claudiusmarius/CONCEPTION-TESTEUR-PILES-PARTIE-1-DFTA247/pinochesss.jpg

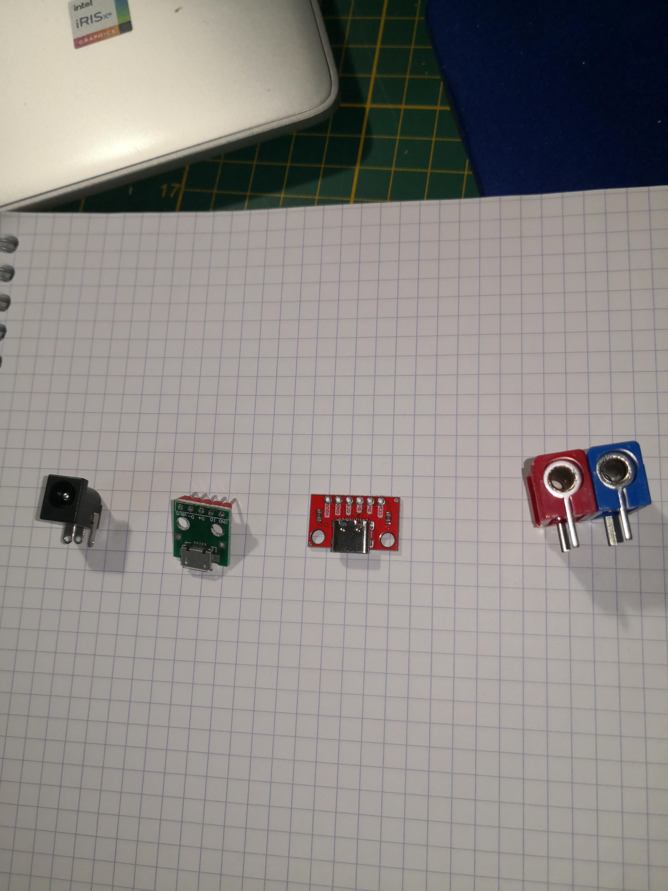
pinochesss.jpg
