claudiusmarius/CONCEPTION-TESTEUR-PILES-PARTIE-1-DFTA247/Schematic_DFTA247_2025-11-29.pdf

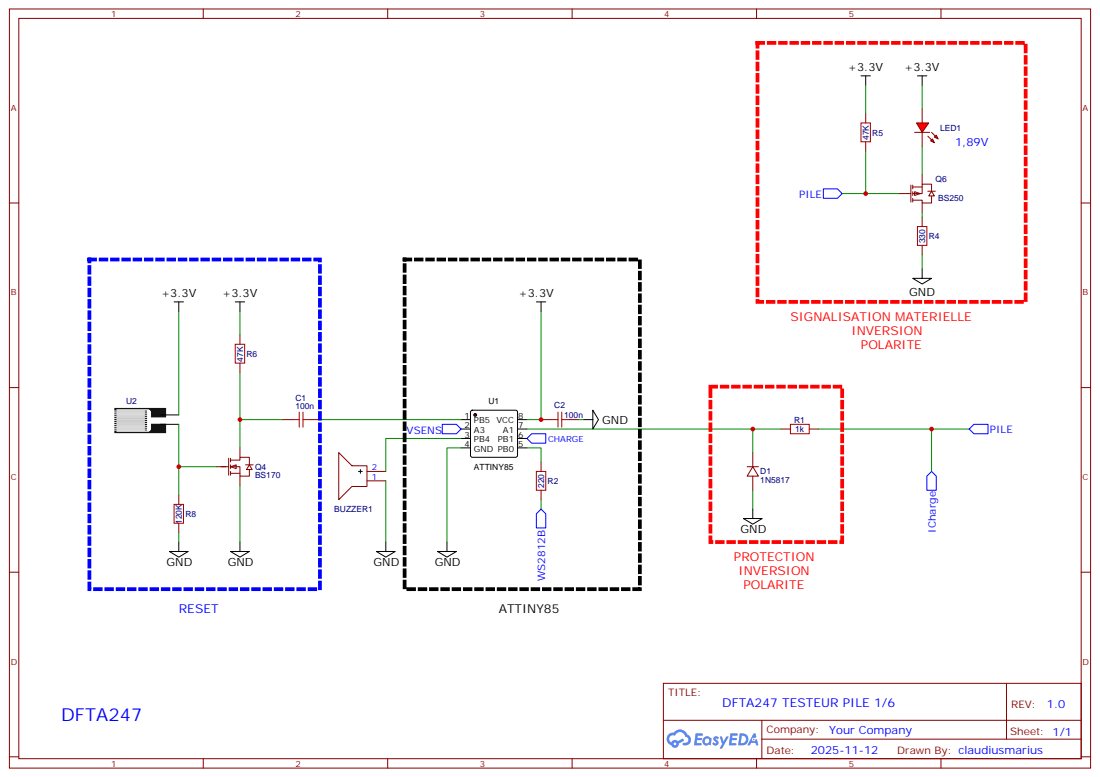
[picture p2: page 1]
