claudiusmarius/CONCEPTION-TESTEUR-PILES-PARTIE-1-DFTA247/Schematic_DFTA247_2025-11-29 (1).pdf

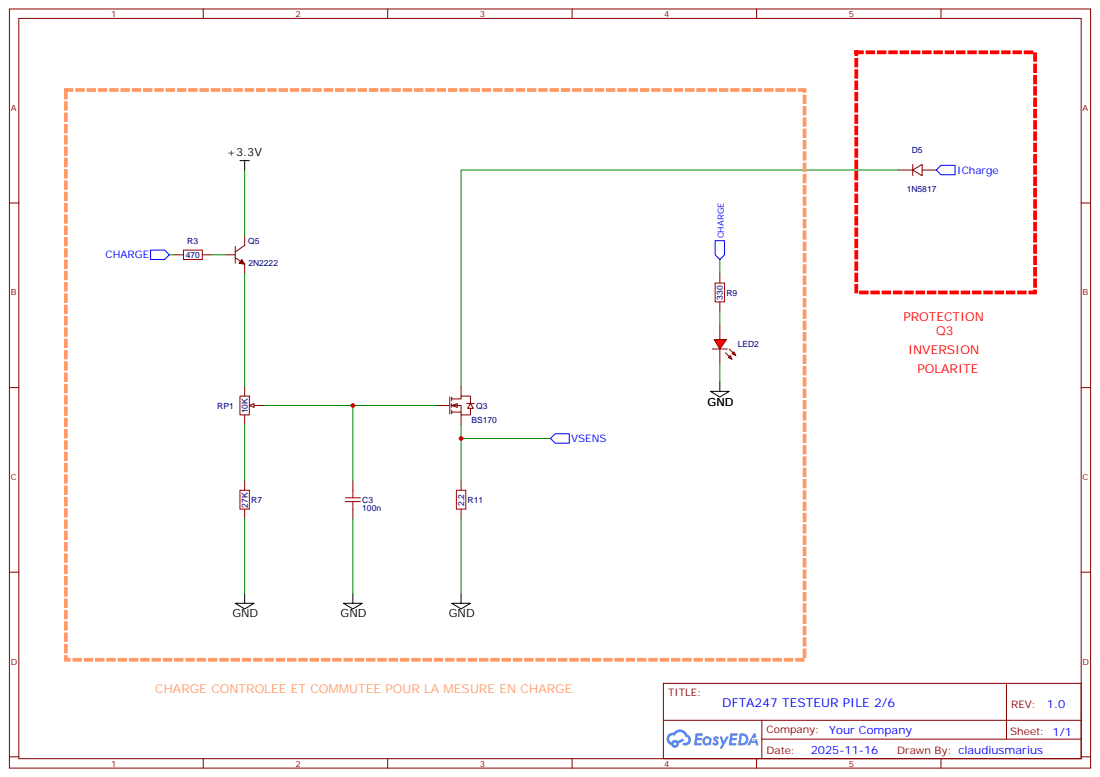
[picture p3: page 1]

CHARGE CONTROLEE ET COMMUTEE POUR LA MESURE EN CHARGE
