claudiusmarius/CONCEPTION-TESTEUR-PILES-PARTIE-1-DFTA247/Schematic_DFTA247_2025-11-29 (2).pdf

+5V

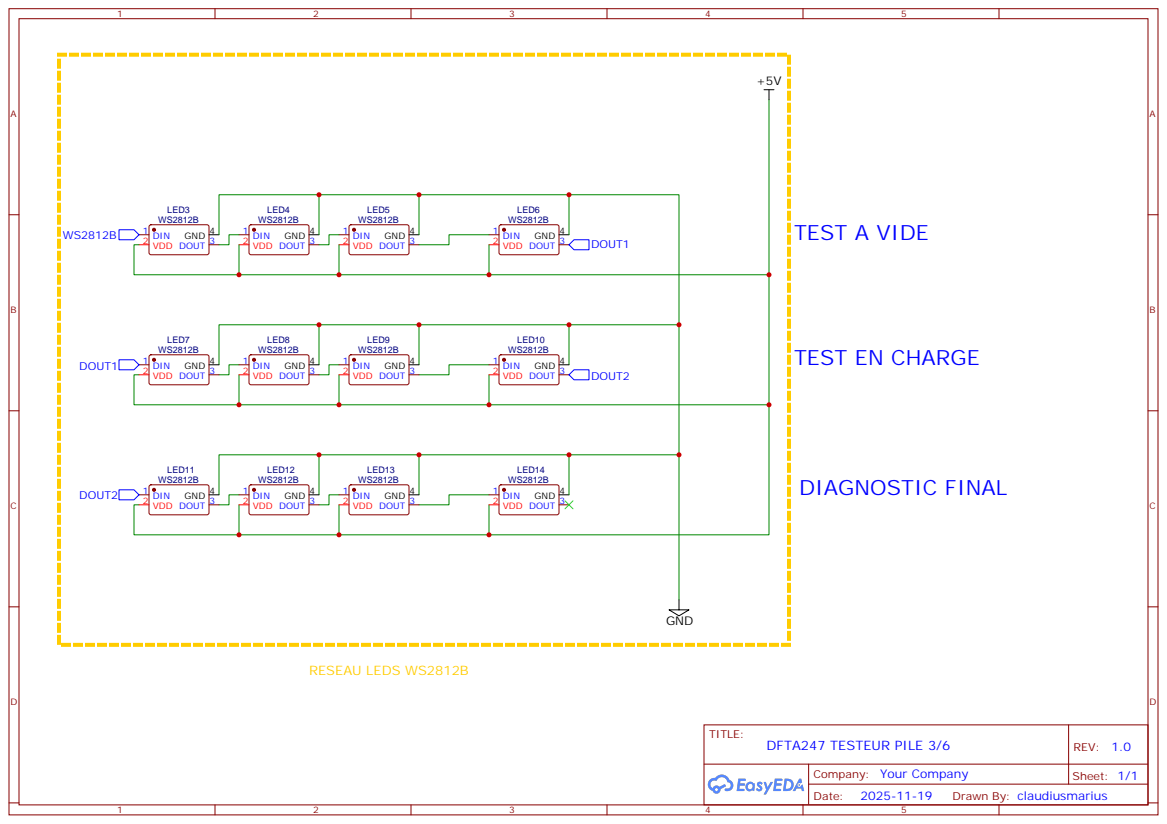
[picture p4: page 1]
