claudiusmarius/CONCEPTION-TESTEUR-PILES-PARTIE-1-DFTA247/Schematic_DFTA247_2025-11-29 (3).pdf

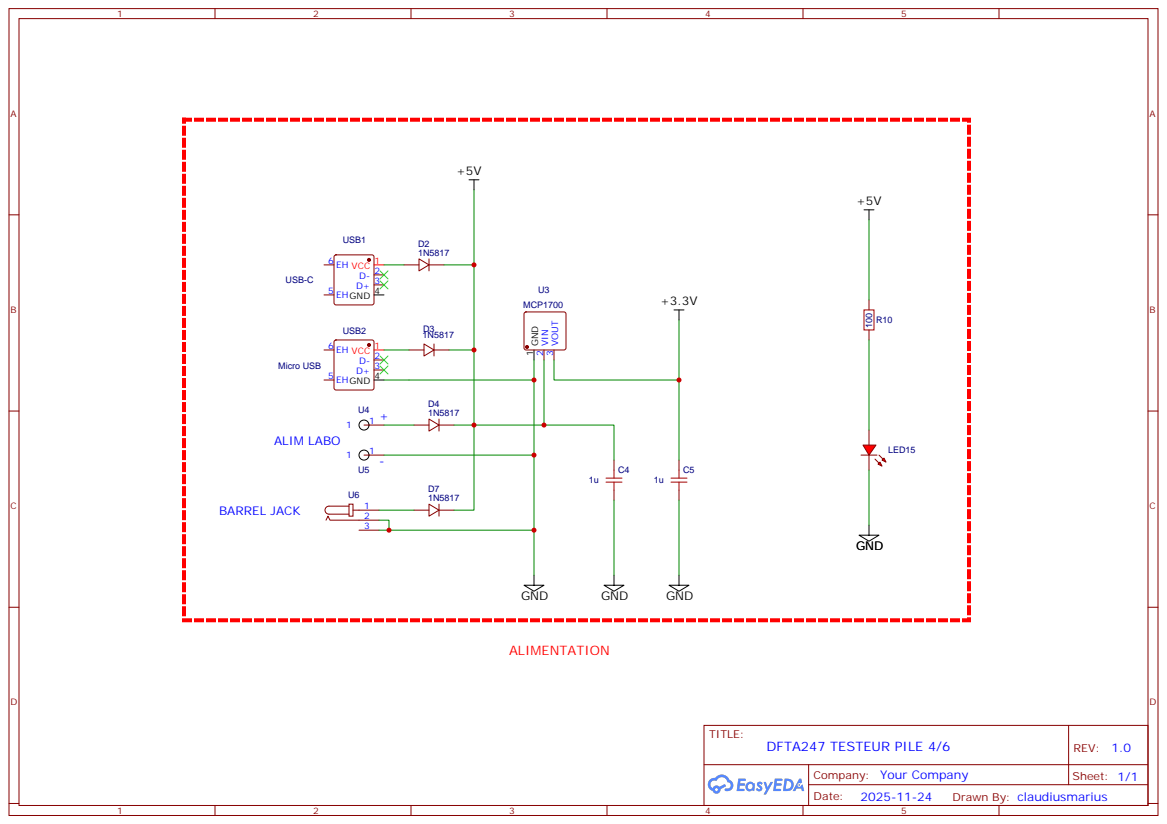
[picture p5: page 1]
