claudiusmarius/CONCEPTION-TESTEUR-PILES-PARTIE-1-DFTA247/Schematic_DFTA247_2025-11-29 (4).pdf

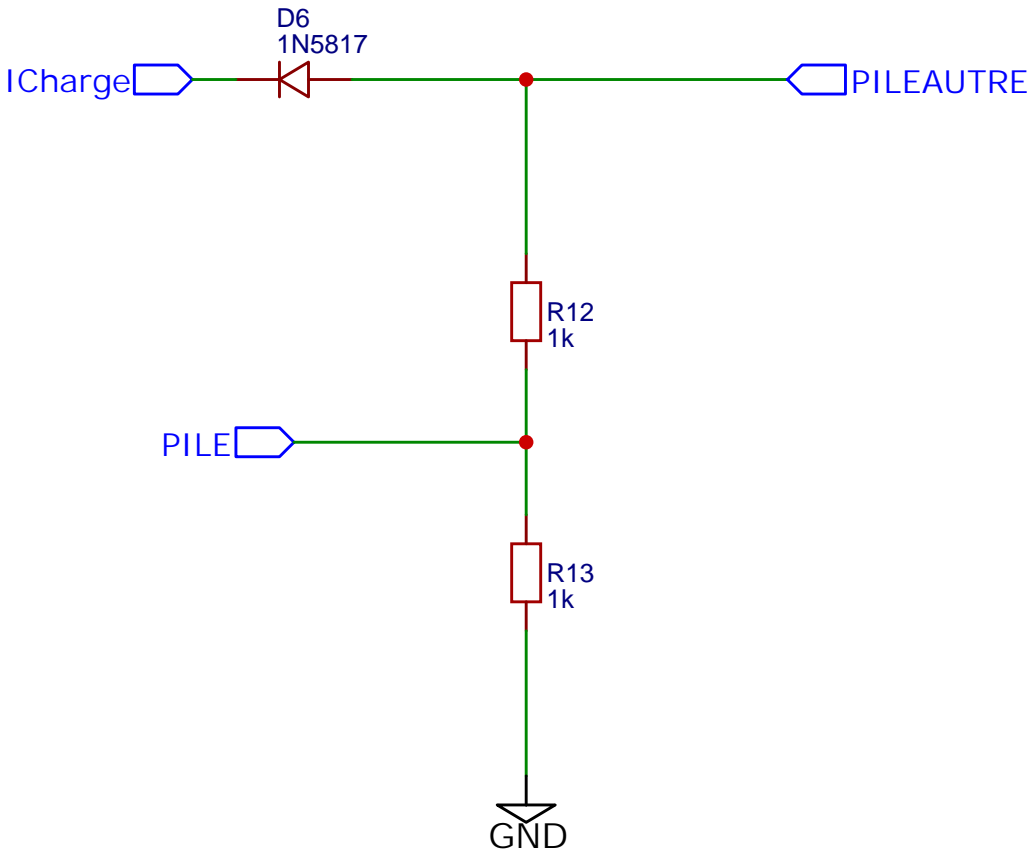
[picture p6: page 1]
