claudiusmarius/CONCEPTION-TESTEUR-PILES-PARTIE-1-DFTA247/Schematic_DFTA247_2025-11-29 (5).pdf

# TEST A VIDE

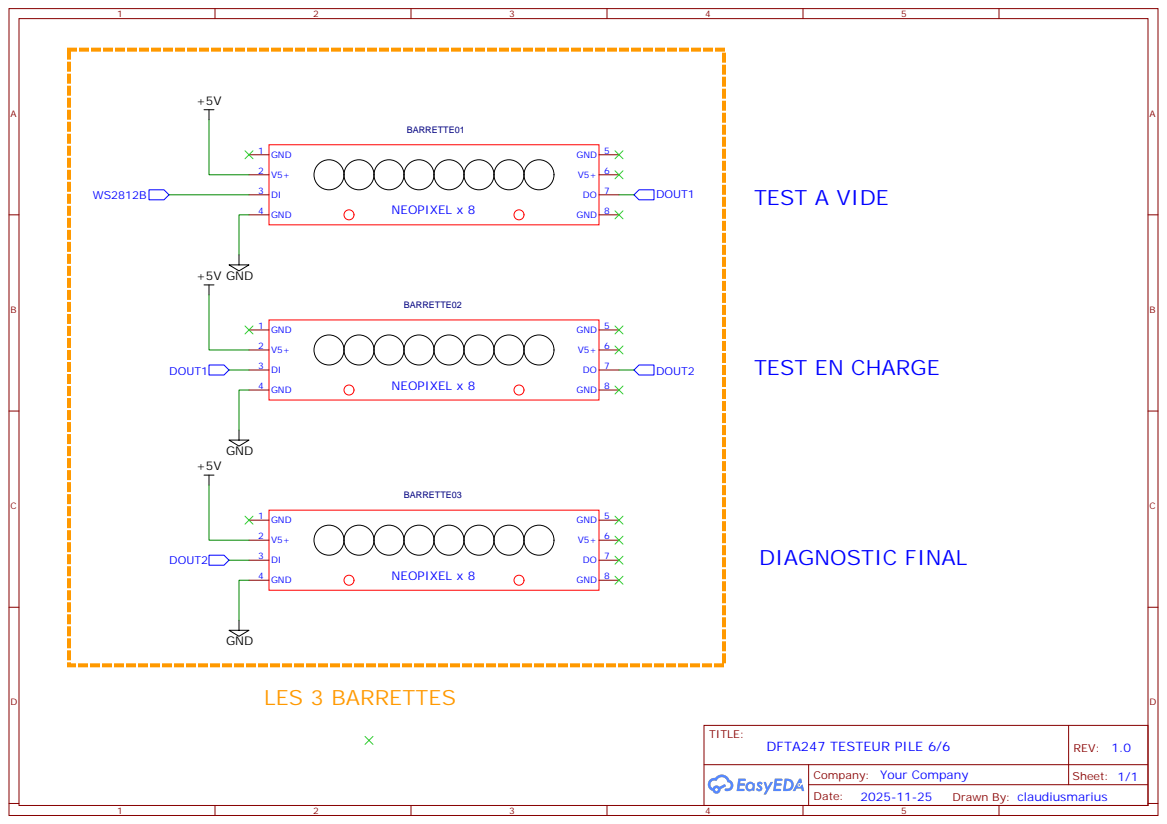
[picture p7: page 1]
